tilties2/Haptic-OmniQuad/Haptic_RC/electronics/Power_Board/case-top.stl

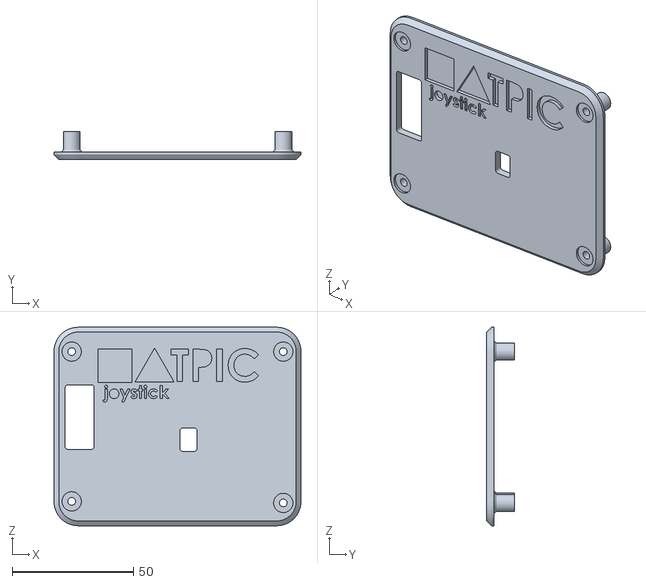
[picture p3: CAD file, 2024-09-26]
Haptic_RC/electronics/Power_Board/case-top.stl
102.0 x 11.5 x 82.0
