tilties2/Haptic-OmniQuad/Haptic_RC/parts/inner-coupling.STL

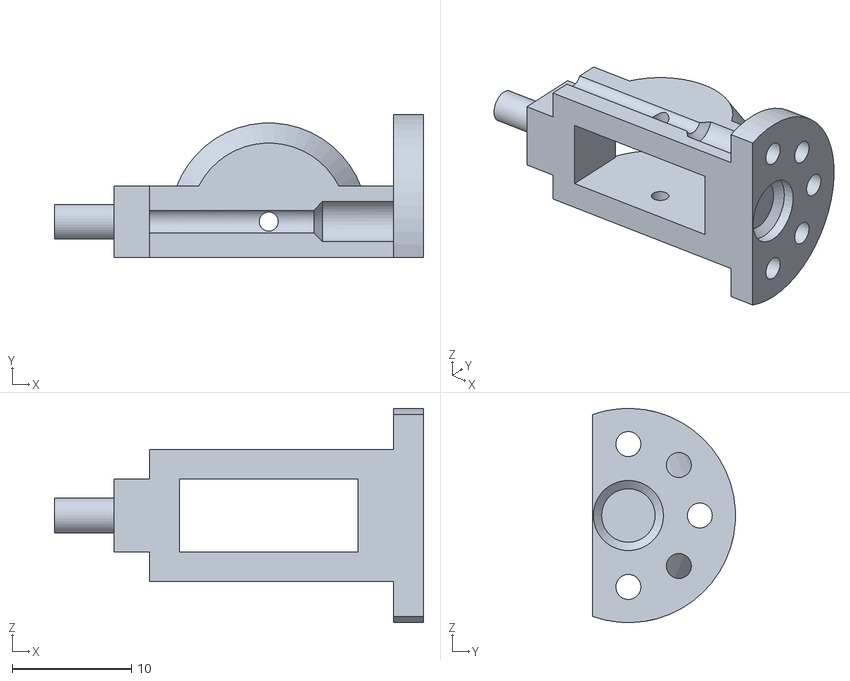
[picture p4: CAD file, 2024-09-13]
Haptic_RC/parts/inner-coupling.STL
31.0 x 12.0 x 18.0
