tilties2/Haptic-OmniQuad/Haptic_RC/electronics/Power_Board/case-bottom.stl

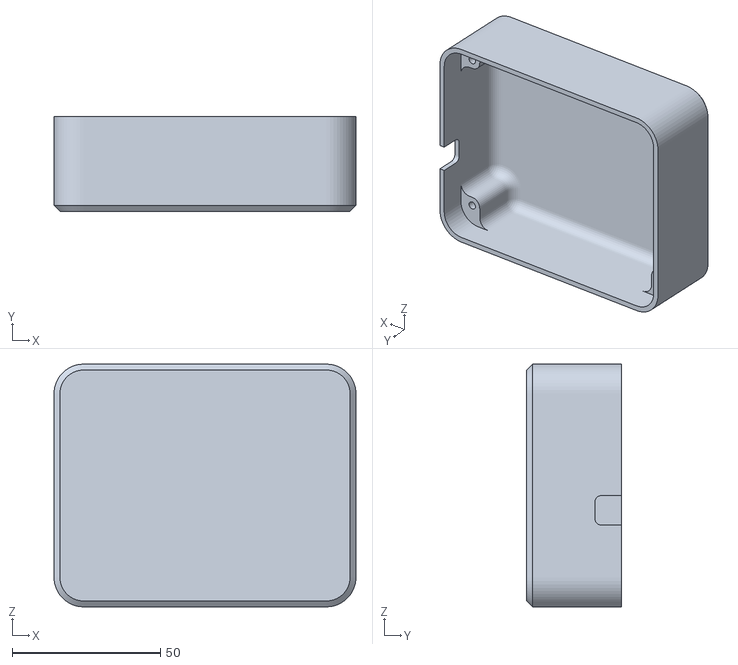
[picture p5: CAD file, 2024-09-26]
Haptic_RC/electronics/Power_Board/case-bottom.stl
102.0 x 32.0 x 82.0
