tilties2/Haptic-OmniQuad/Haptic_RC/parts/back-cover.stl

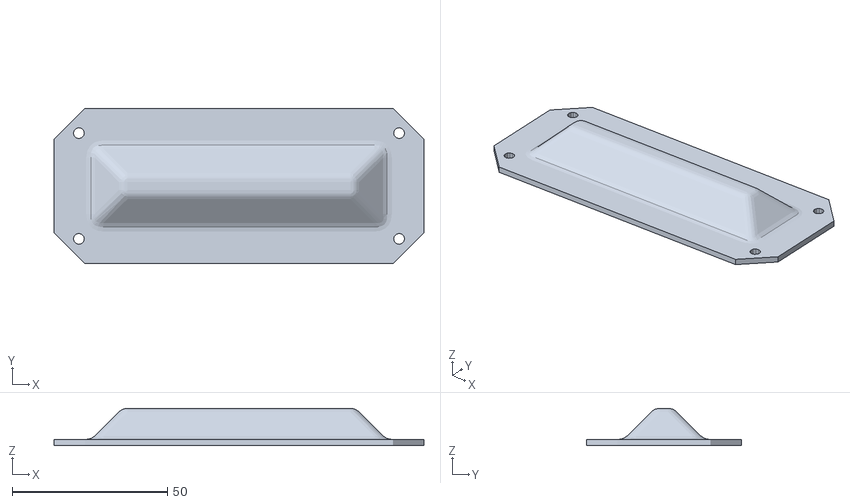
[picture p6: CAD file, 2024-09-13]
Haptic_RC/parts/back-cover.stl
119.0 x 50.0 x 12.0
