tilties2/Haptic-OmniQuad/Haptic_RC/parts/stick.stl

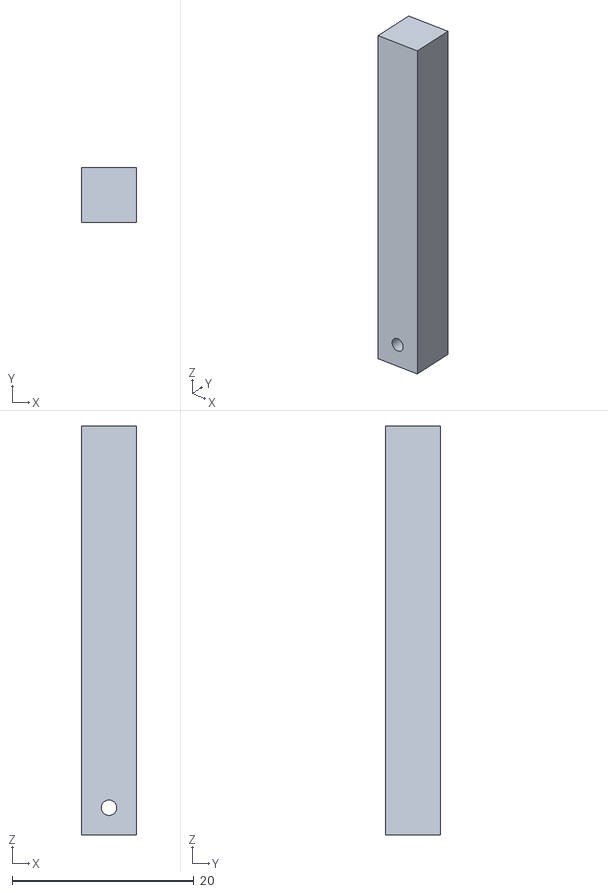
[picture p7: CAD file, 2024-09-13]
Haptic_RC/parts/stick.stl
6.00 x 6.00 x 45.0
