tilties2/Haptic-OmniQuad/Haptic_RC/parts/bottom-shell.stl

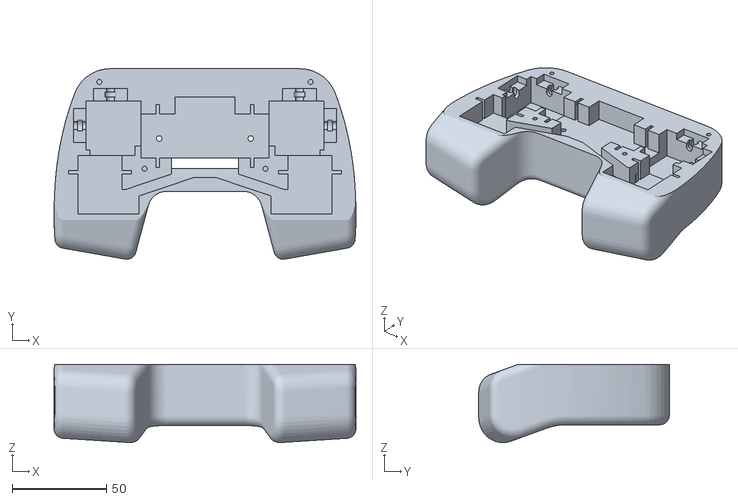
[picture p8: CAD file, 2024-09-13]
Haptic_RC/parts/bottom-shell.stl
160.1 x 101.0 x 41.4
