tilties2/Haptic-OmniQuad/Haptic_RC/parts/outer-coupling.stl

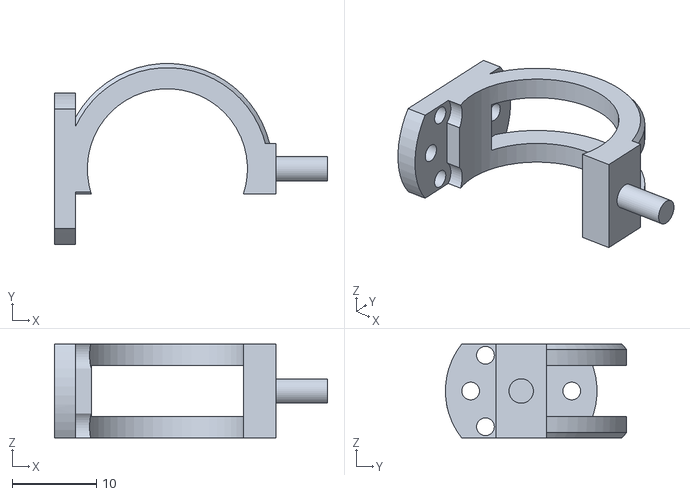
[picture p9: CAD file, 2024-09-13]
Haptic_RC/parts/outer-coupling.stl
32.4 x 21.5 x 11.1
