tilties2/Haptic-OmniQuad/Haptic_RC/parts/top-shell.stl

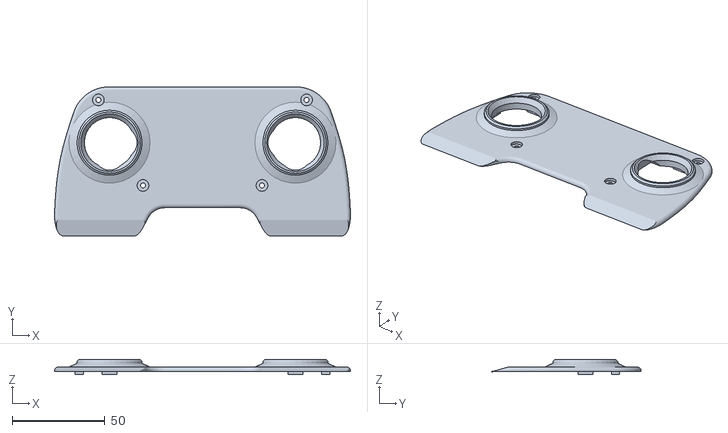
[picture p10: CAD file, 2024-09-13]
Haptic_RC/parts/top-shell.stl
159.2 x 80.3 x 7.99
