tilties2/Haptic-OmniQuad/Haptic_RC/electronics/PCB_IMU/HapticRC_IMU_Schematic.pdf

## IMU

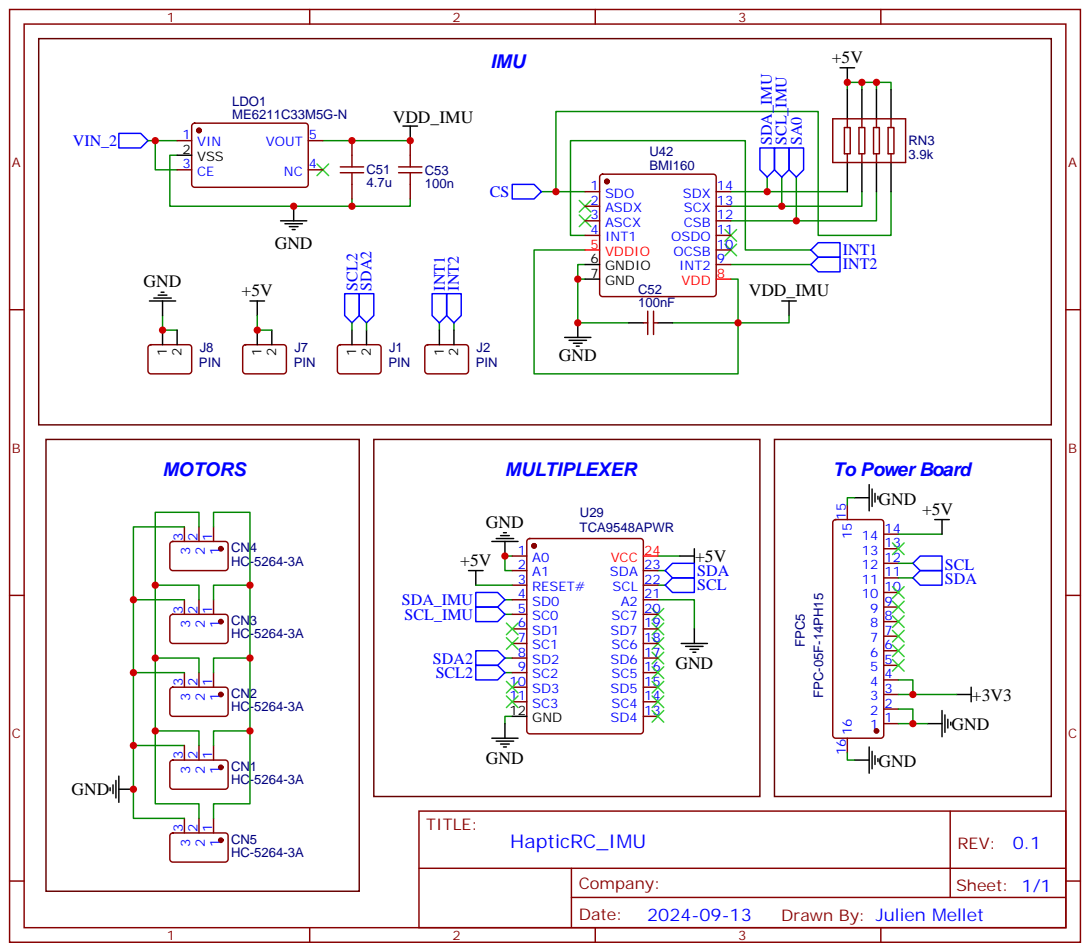
[picture p11: page 1]

Drawn By: Julien Mellet
