tilties2/Haptic-OmniQuad/Haptic_RC/electronics/Power_Board/HapticRC_PowerBoard_Schematic.pdf

## CHARGING & PROTECTION CIRCUIT

## TTLinker (isolated)

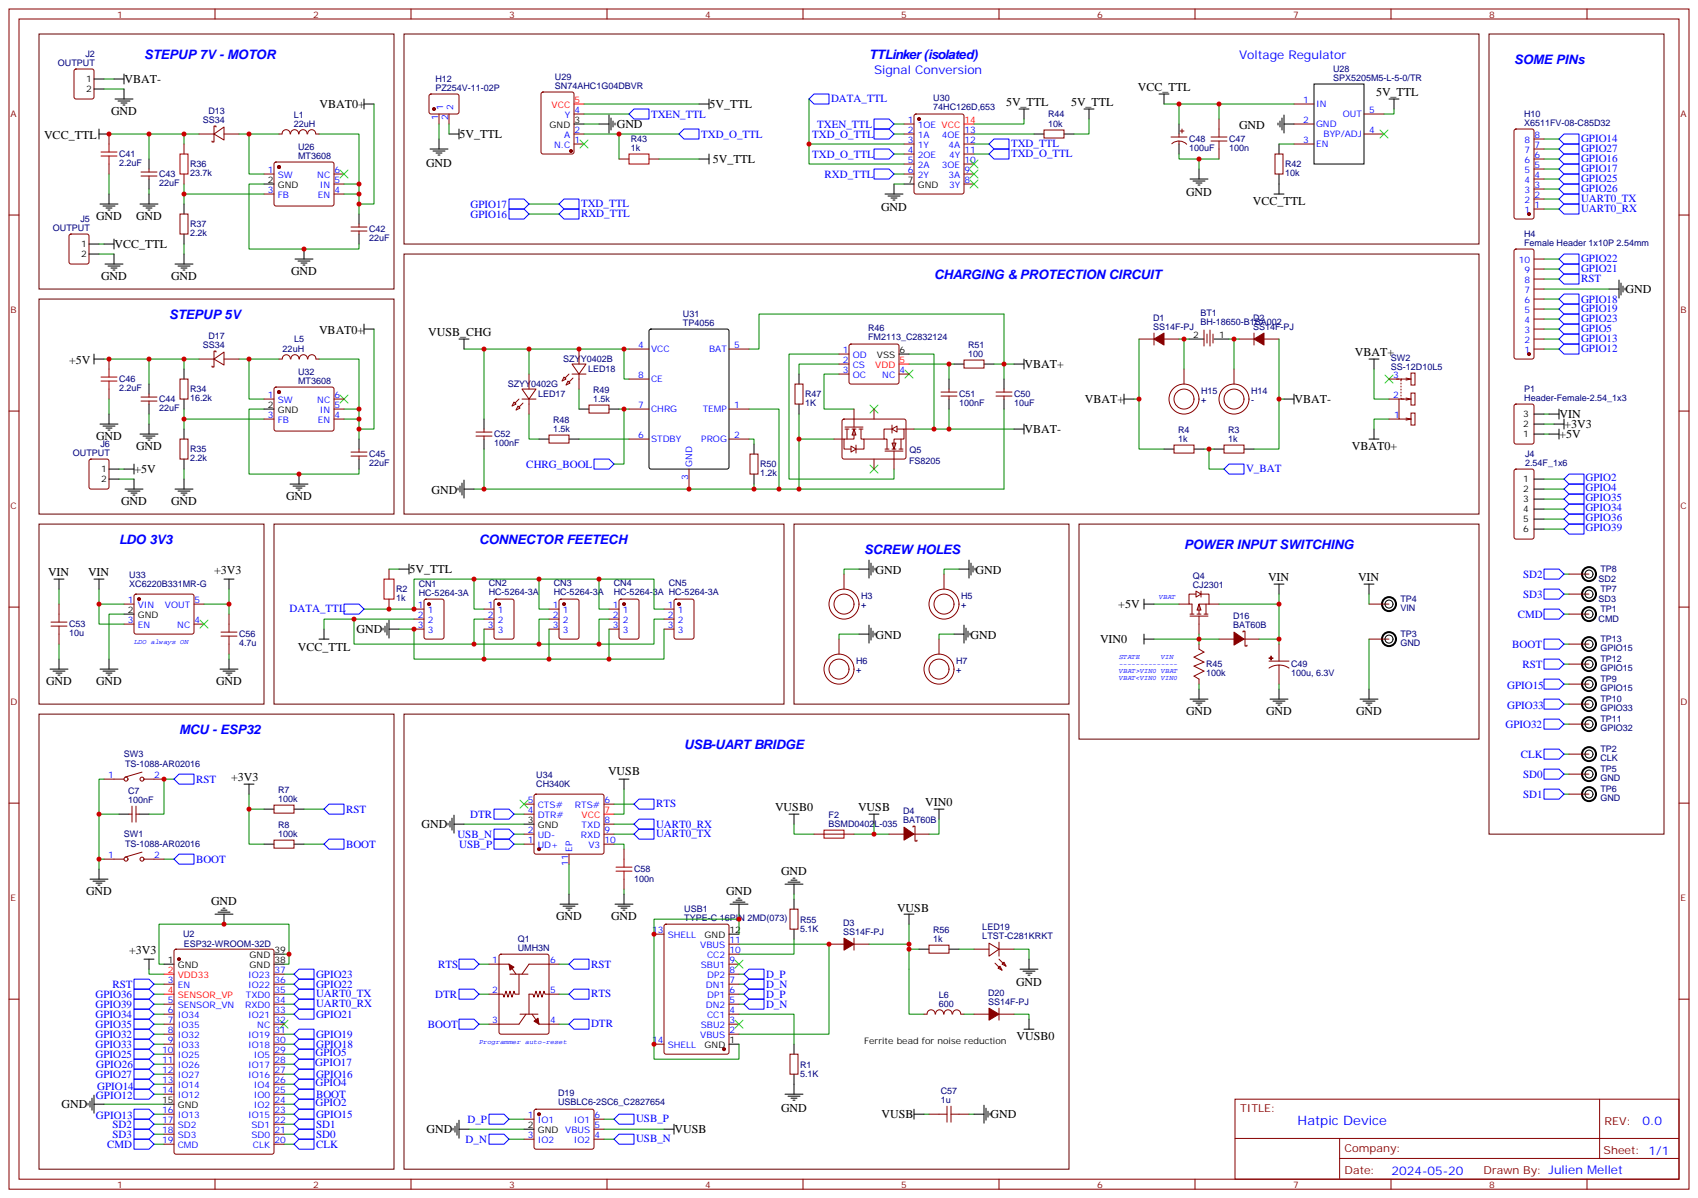
[picture p12: page 1]

Ferrite bead for noise reduction

Drawn By: Julien Mellet
