tilties2/Haptic-OmniQuad/Haptic_RC/electronics/Power_Board/HapticRC_PowerBoard_Layers.pdf

CN3 | CN4 | CN5 H4

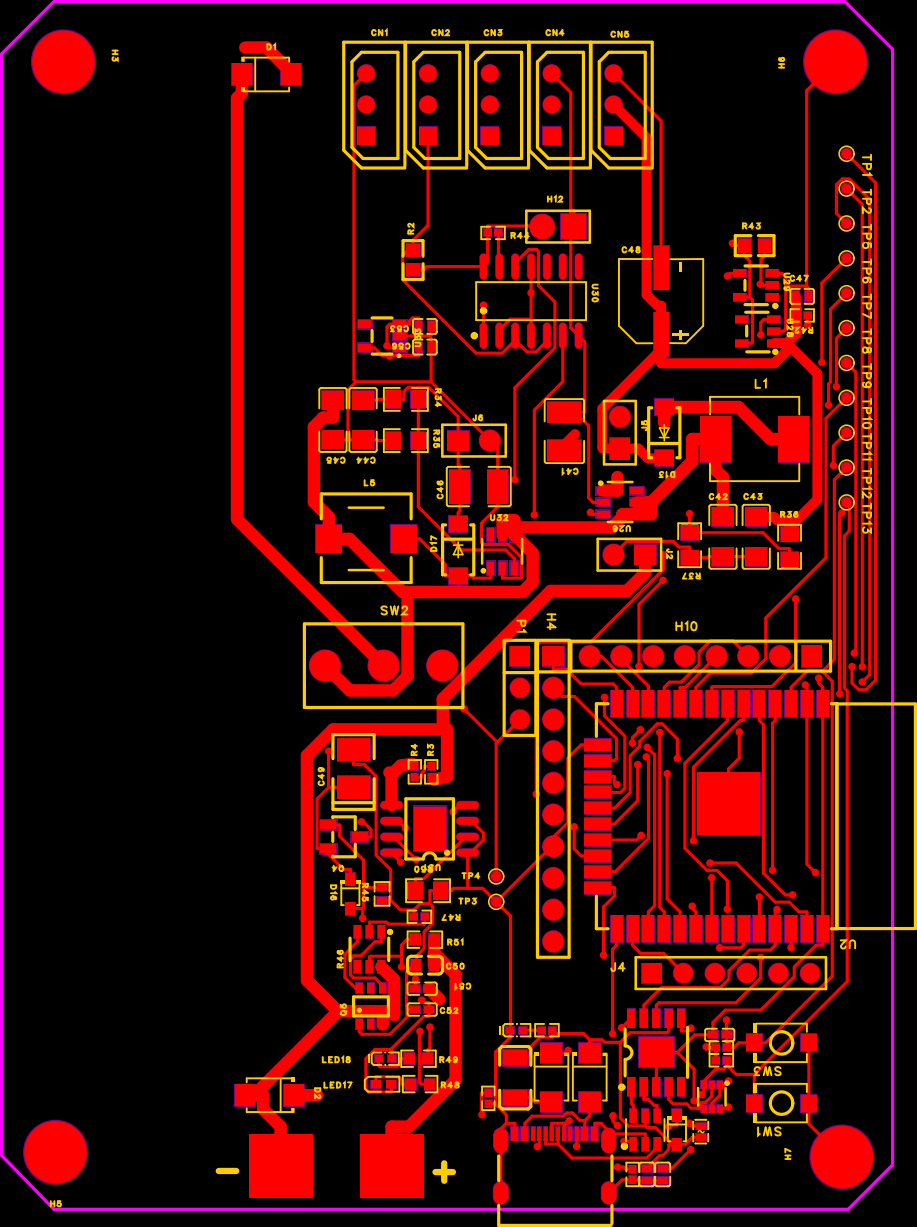
[picture p13: page 1]

BT1

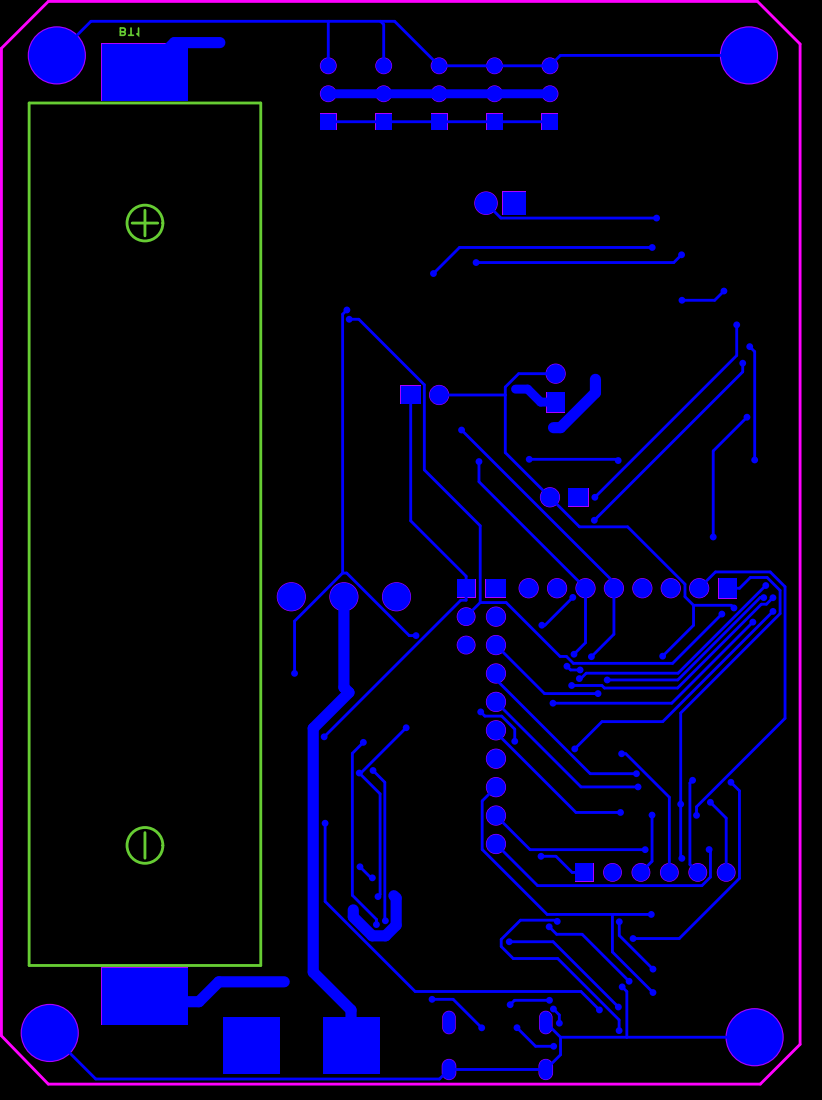
[picture p14: page 2]
