tilties2/Haptic-OmniQuad/Haptic_RC/electronics/PCB_IMU/HapticRC_IMU_Layers.pdf

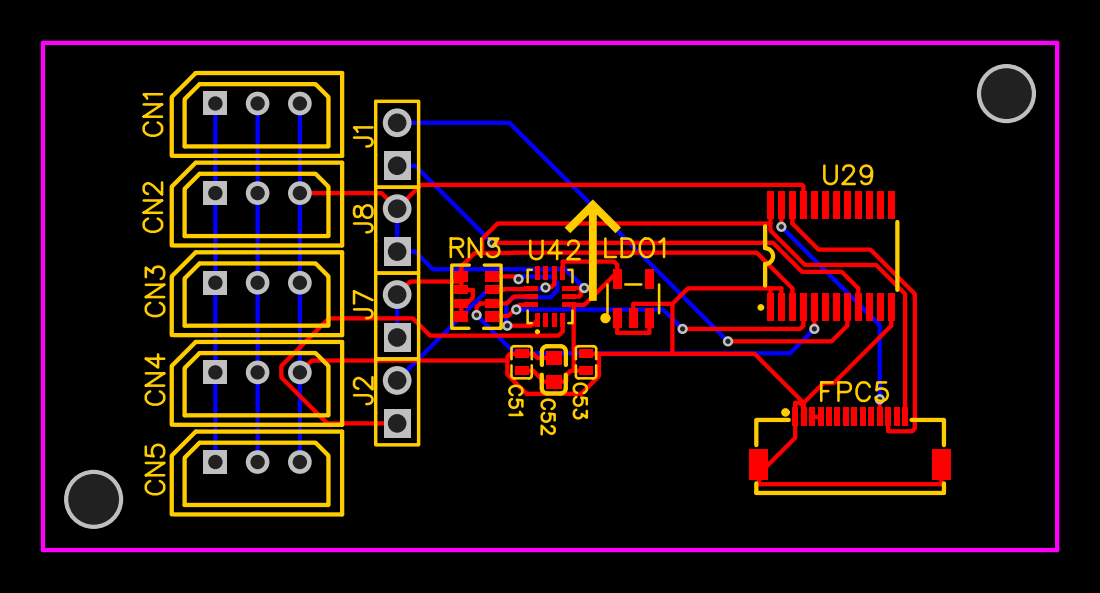
[picture p15: page 1]
