tilties2/Haptic-OmniQuad/(list of files, drawings)

Other design files:
Haptic_RC/electronics/PCB_IMU/HapticRC_IMU_PCB.pcbdoc
Haptic_RC/electronics/Power_Board/HapticRC_PowerBoard_PCB.pcbdoc
