tilties2/Haptic-OmniQuad/(commit log)

2024-09-13 Add stl of the haptic device
    [bottom-shell.STL, outer-coupling.STL, stick.STL, top-shell.STL]
2024-09-13 Add some some part of the drone
    [battery-spacer.STL, cap-arm.stl, frame-bottom.stl]
2024-09-13 Add generative designed frame
2024-09-13 Add robot tilting CF arm
    [arm-carbon-fiber.step]
2024-09-13 Add coupling parts and landing gear TPU tip
    [coupling-arm-down.stl, coupling-arm-up.stl, landing-gear-tip.stl]
2024-09-13 Add electronics schems
    [HapticRC_IMU_PCB.pcbdoc, HapticRC_PowerBoard_PCB.pcbdoc]
2024-09-13 Add joystick ESP32 software
2024-09-13 Add back cover
    [back-cover.stl]
2024-09-13 Add inner coupling
    [inner-coupling.STL]
2024-09-14 Reload image with bearing
2024-09-14 Modified Haptic Device Image
2024-09-14 Add image arm tear down
2024-09-26 Refacto and update electronics
    [HapticRC_IMU_PCB.pcbdoc, HapticRC_PowerBoard_PCB.pcbdoc, case-bottom.stl, case-top.stl]
2025-03-21 omniquad is now a submodule
    [arm-carbon-fiber.step, battery-spacer.stl, cap-arm.stl, coupling-arm-down.stl, coupling-arm-up.stl, frame-bottom.stl, landing-gear-tip.stl]
